cydrollinger/USB_FPGA/Docs/USB_FPGA/Readme.txt

********************************************************************************************
* Electronic Realization L.L.C.								   *
* Design: Open Hardware Source   USB Configurable Field Programmable Gate Array  	   *
*						USB_FPGA board				   *
* License: TAPR - http://www.tapr.org/OHL						   *
* Engineer: Cy Drollinger								   *
* Date: June 26th, 2012								           *
* Email: cy@elec-real.com								   *
* Address: 313 W. mendenhall #5 Bozeman, MT 59715					   *
* Phone: 406-586-5502									   *
********************************************************************************************

*******************************************
*File Arcitecture with a small description*
*******************************************

files:
		may 27 - The goals at the start of the design and the resources utilized 
		pcb_prob_soulutions - keeping track of flaws and there solutions
		pds_3an - documentation of the power distribution system designed for the FPGA
		usb power design - caluculations utilized for the resistor dividers for the LTC3544

		These files were utilized in the design process here at Electronic Realization to
		facilitate a successful outcome of the open source hardware design of the USB_FPGA.
