cydrollinger/USB_FPGA/FirstVersion/usb_fpga/order/pcb_specs.rtf

USB_FPGA

PCB specifications:

four layer board

standard substrate: fr4
thickness: .062"
dimensions: 3.2" x 2"
copper thickness: 1 oz. all layers
colors: no preference standard
all units: inches
