cydrollinger/USB_FPGA/Docs/USB_FPGA/usb power design.xls

Switching Regulator
LTC3544
projects\usb_fpga\docs\pdf\3544bfa pg.10
Vout = .8V(1 + R2/R1)
 |  | Vout | R1 | R2
 | V100 | 1.2 | 1000 | 500.00
 | V200A | 1.8 | 1000 | 1250.00
 | V200B | 2.5 | 1000 | 2125.00
 | V300 | 3.3 | 1000 | 3125.00
