cydrollinger/USB_FPGA/FirstVersion/usb_fpga/brd/board.png

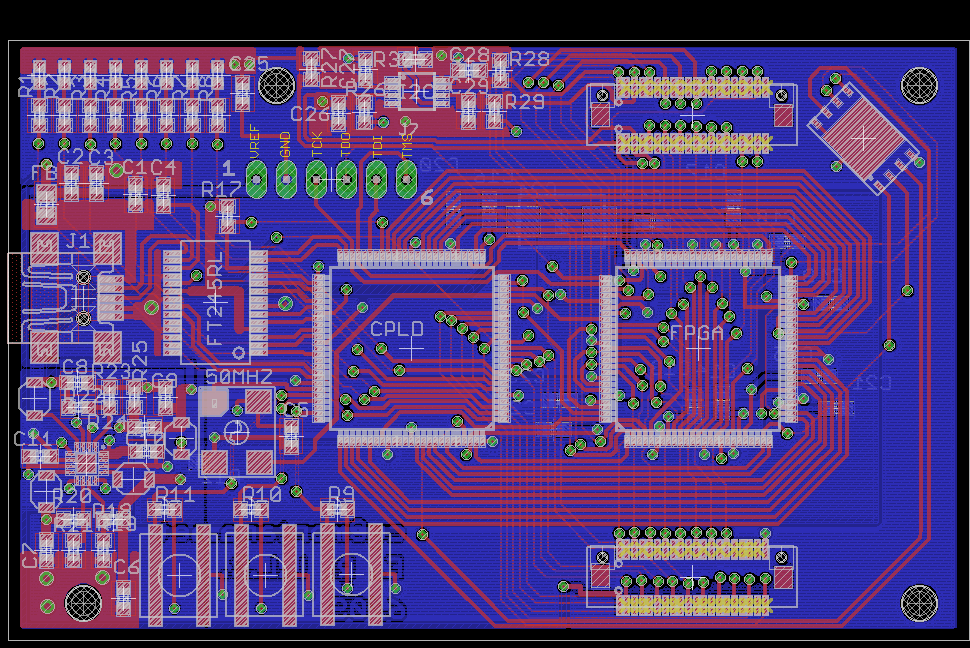
FirstVersion/usb_fpga/brd/board.png
