cydrollinger/USB_FPGA/FirstVersion/usb_fpga/brd/brd.png

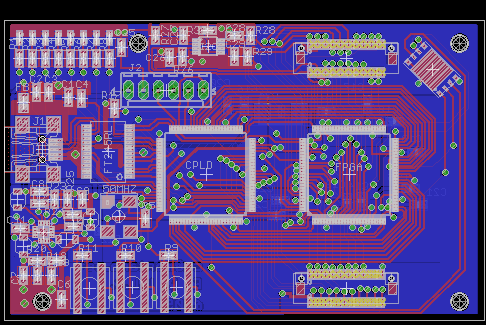
FirstVersion/usb_fpga/brd/brd.png
