cydrollinger/USB_FPGA/FirstVersion/usb_fpga/pg1.png

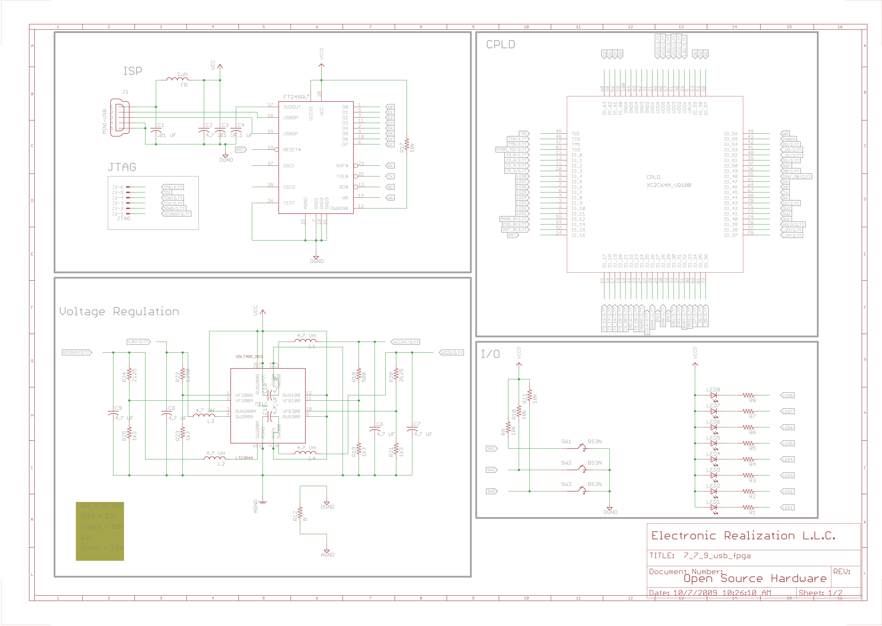
FirstVersion/usb_fpga/pg1.png
