cydrollinger/USB_FPGA/FirstVersion/usb_fpga/pg2.png

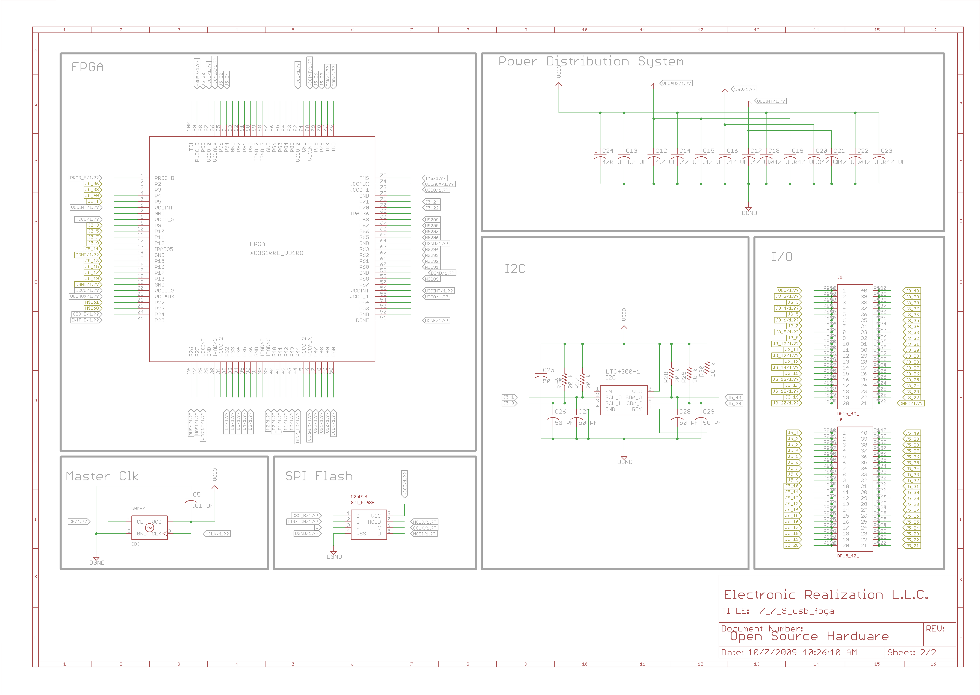
FirstVersion/usb_fpga/pg2.png
