cydrollinger/USB_FPGA/FirstVersion/usb_fpga/schematic/pg_1.png

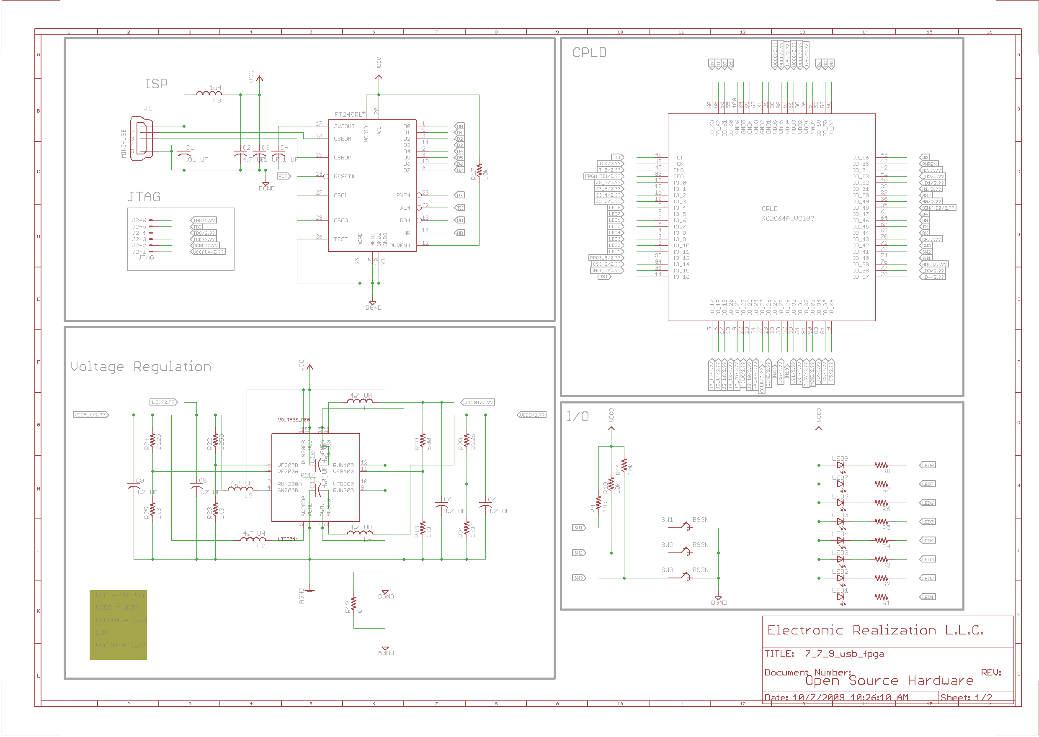
FirstVersion/usb_fpga/schematic/pg_1.png
