cydrollinger/USB_FPGA/FirstVersion/usb_fpga/usb_fpga.jpg

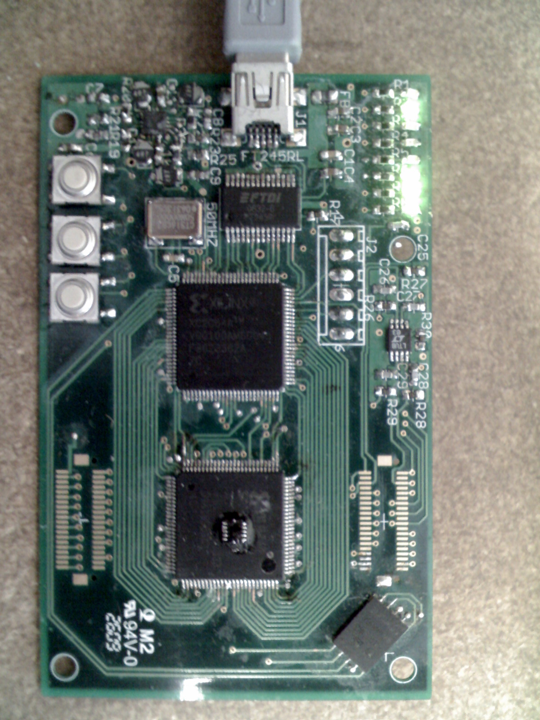
FirstVersion/usb_fpga/usb_fpga.jpg
