cydrollinger/USB_FPGA/FirstVersion/usb_fpga/web_usb_fpga-1/web_usb_fpga/content/Cartoon_brd.png

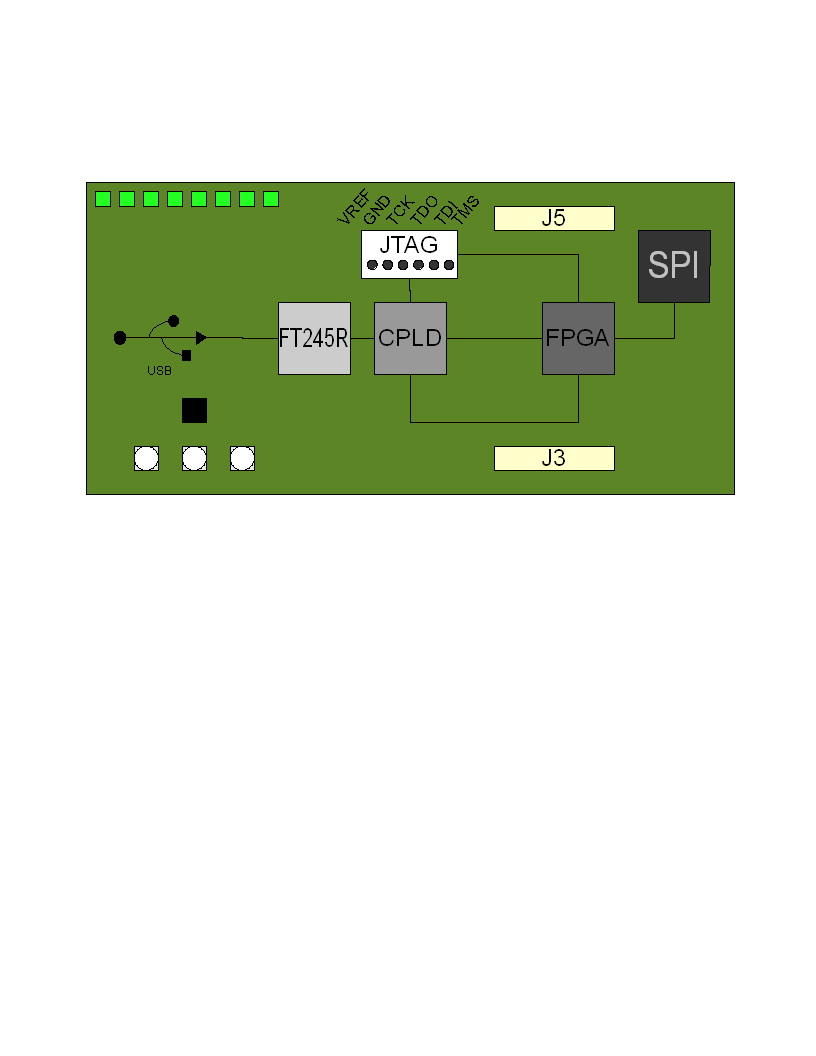
FirstVersion/usb_fpga/web_usb_fpga-1/web_usb_fpga/content/Cartoon_brd.png
