cydrollinger/USB_FPGA/IMG_0864.JPG

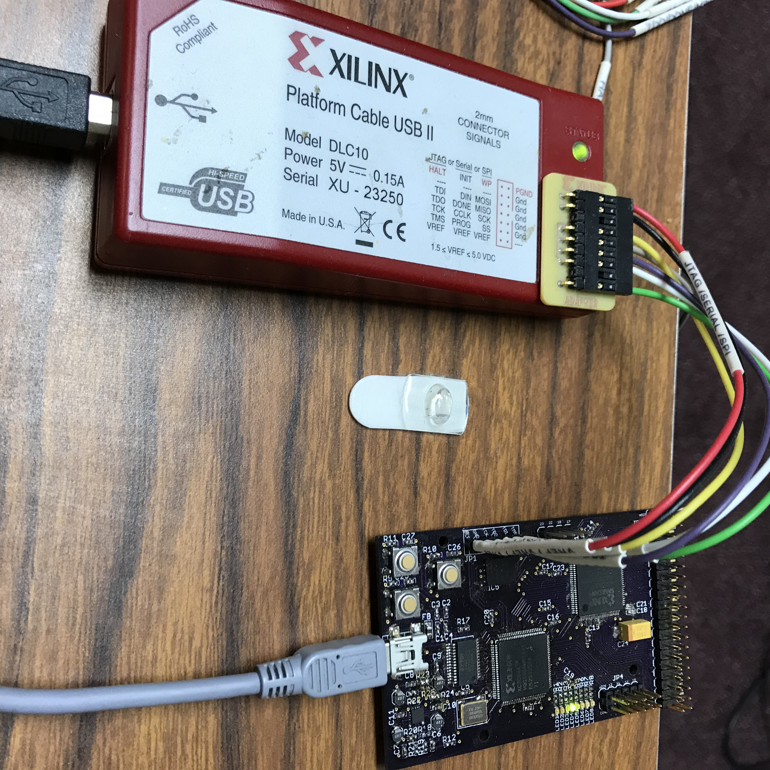
IMG_0864.JPG
