cydrollinger/USB_FPGA/FirstVersion/usb_fpga/order/usb_fpga_II.xls

Index | Quantity | Part Number | Description | Backorder Quantity | Unit Price | Extended Price | Part | parts/assy
 |  |  |  |  | USD | USD
1 (https://ordering.digikey.com/Ordering/LineItem.aspx?itemSeq=75083495) | 100 | 587-1441-1-ND | CAP CER 4.7UF 10V X5R 0603 | 0 | 0.195 | $19.50 | C2, C6, C7, C8, C9, C10, C11, C12, C13 | 9
2 (https://ordering.digikey.com/Ordering/LineItem.aspx?itemSeq=75083820) | 100 | 587-1250-1-ND | CAP CER .47UF 16V X7R 0603 | 0 | 0.0455 | $4.55 | C14, C15, C16, C17 | 4
3 (https://ordering.digikey.com/Ordering/LineItem.aspx?itemSeq=75083886) | 100 | 587-1240-1-ND | CAP CER .10UF 16V X7R 0603 | 0 | 0.0163 | $1.63 | C3, C4 | 2
4 (https://ordering.digikey.com/Ordering/LineItem.aspx?itemSeq=75083930) | 100 | 587-1239-1-ND | CAP CER 47000PF 16V X7R 0603 | 0 | 0.0325 | $3.25 | C18, C19, C20, C21, C22, C23, C30 | 7
5 (https://ordering.digikey.com/Ordering/LineItem.aspx?itemSeq=75084377) | 100 | 490-1420-1-ND | CAP CER 51PF 50V 5% C0G 0603 | 0 | 0.0423 | $4.23 | C25, C26, C27, C28, C29 | 5
6 (https://ordering.digikey.com/Ordering/LineItem.aspx?itemSeq=75084468) | 100 | 490-1525-1-ND | CAP CER 10000PF 16V 10% X7R 0603 | 0 | 0.0319 | $3.19 | C1, C5 | 2
7 (https://ordering.digikey.com/Ordering/LineItem.aspx?itemSeq=75094234) | 25 | SW261CT-ND | SWITCH TACT SMD W/O GND 160GF | 0 | 0.6772 | $16.93 | SW1, SW2, SW3 | 3
8 (https://ordering.digikey.com/Ordering/LineItem.aspx?itemSeq=75094256) | 3 | 122-1479-ND | IC SPARTAN-3E FPGA 100K 100VTQFP | 0 | 9.48 | $28.44 | fpga | 1
9 (https://ordering.digikey.com/Ordering/LineItem.aspx?itemSeq=75094321) | 3 | CTX283CT-ND | OSC 50.000 MHZ 5.0V SMD | 0 | 3.73 | $11.19 | 50MHZ | 1
10 (https://ordering.digikey.com/Ordering/LineItem.aspx?itemSeq=75094667) | 100 | 160-1183-1-ND | LED GREEN CLEAR 0603 SMD | 0 | 0.06 | $6.00 | LED1, LED2, LED3, LED4, LED5, LED6, LED7, LED8 | 8
11 (https://ordering.digikey.com/Ordering/LineItem.aspx?itemSeq=75094806) | 3 | 495-1517-1-ND | CAP TANT 470UF 6.3V 10%LOESR SMD | 0 | 1.44 | $4.32 | C24 | 1
12 (https://ordering.digikey.com/Ordering/LineItem.aspx?itemSeq=75094931) | 5 | 768-1011-1-ND | IC USB TO PARALLEL FIFO 28-SSOP | 0 | 4.5 | $22.50 | FT245RL | 1
13 (https://ordering.digikey.com/Ordering/LineItem.aspx?itemSeq=75095521) | 5 | LTC4300-1CMS8#PBF-ND | IC HOTSWAP 2WIRE BUS BUFFR 8MSOP | 0 | 3.5 | $17.50 | I2C | 1
14 (https://ordering.digikey.com/Ordering/LineItem.aspx?itemSeq=75095574) | 20 | 445-3217-1-ND | INDUCTOR POWER 4.7UH .70A SMD | 0 | 0.8 | $16.00 | L1, L2, L3, L4 | 4
15 (https://ordering.digikey.com/Ordering/LineItem.aspx?itemSeq=75095642) | 5 | H2959CT-ND | CONN RECEPT MINI USB2.0 5POS | 0 | 1.18 | $5.90 | J1 | 1
16 (https://ordering.digikey.com/Ordering/LineItem.aspx?itemSeq=75095796) | 5 | M25P16-VME6G-ND | IC SRL FLASH 16MBIT LV 8-VDFPN | 0 | 3.95 | $19.75 | SPI_FLASH | 1
17 (https://ordering.digikey.com/Ordering/LineItem.aspx?itemSeq=75096237) | 4 | H10427CT-ND | CONN RECEPT 40POS .8MM DUAL SMD | 0 | 2.47 | $9.88 | J3, J5 | 2
18 (https://ordering.digikey.com/Ordering/LineItem.aspx?itemSeq=75096346) | 4 | H10447CT-ND | CONN HEADER 40POS 3.2MM DUAL SMD | 0 | 1.95 | $7.80 | J4, J6 | 2
19 (https://ordering.digikey.com/Ordering/LineItem.aspx?itemSeq=75096442) | 5 | LTC3544BEUD#PBF-ND | IC REG SYNC QUAD 16-QFN | 0 | 5.9 | $29.50 | VOLTAGE_REG | 1
20 (https://ordering.digikey.com/Ordering/LineItem.aspx?itemSeq=75096610) | 50 | RHM165HCT-ND | RES 165 OHM 1/10W 1% 0603 SMD | 0 | 0.0408 | $2.04 | R1, R2, R3, R4, R5, R6, R7, R8 | 8
21 (https://ordering.digikey.com/Ordering/LineItem.aspx?itemSeq=75096701) | 50 | RHM1.00KHCT-ND | RES 1.00K OHM 1/10W 1% 0603 SMD | 0 | 0.0408 | $2.04 | R19, R21, R23, R25 | 4
22 (https://ordering.digikey.com/Ordering/LineItem.aspx?itemSeq=75096726) | 50 | RHM10.0KHCT-ND | RES 10.0K OHM 1/10W 1% 0603 SMD | 0 | 0.0408 | $2.04 | R17, R30 | 2
23 (https://ordering.digikey.com/Ordering/LineItem.aspx?itemSeq=75096828) | 50 | RHM20.0KHCT-ND | RES 20.0K OHM 1/10W 1% 0603 SMD | 0 | 0.0408 | $2.04 | R26, R27, R28, R29 | 4
24 (https://ordering.digikey.com/Ordering/LineItem.aspx?itemSeq=75096941) | 50 | RHM499HCT-ND | RES 499 OHM 1/10W 1% 0603 SMD | 0 | 0.0408 | $2.04 | R18 | 1
25 (https://ordering.digikey.com/Ordering/LineItem.aspx?itemSeq=75097201) | 50 | RHM3.16KHCT-ND | RES 3.16K OHM 1/10W 1% 0603 SMD | 0 | 0.0408 | $2.04 | R20 | 1
26 (https://ordering.digikey.com/Ordering/LineItem.aspx?itemSeq=75097247) | 50 | RHM1.24KHCT-ND | RES 1.24K OHM 1/10W 1% 0603 SMD | 0 | 0.0408 | $2.04 | R22 | 1
27 (https://ordering.digikey.com/Ordering/LineItem.aspx?itemSeq=75097331) | 50 | RHM2.15KHCT-ND | RES 2.15K OHM 1/10W 1% 0603 SMD | 0 | 0.0408 | $2.04 | R24 | 1
 |  | 122-1409-ND | cpld |  |  |  | cpld | 1
 |  | 240-2387-1-ND | FB |  |  |  | FB | 1
 |  | WM4104-ND |  |  |  |  | J2 | 1
 |  |  |  |  |  |  |  | 81
