cydrollinger/USB_FPGA/manufacturing/USB_FPGA/parts/digikey.xlsx

Digi-Key Part Number | Manufacturer | Manufacturer Part Number | Customer Reference | Quantity 1 | Quantity 2 | Quantity 3 | Description | Comments | RoHS Status | Lead Free Status | REACH Status
587-1223-1-ND | TAIYO YUDEN (VA) | TMK105B7103KV-F | C1,C5 | 2 | 0 | 0 | CAP CER 10000PF 25V 10% X7R 0402 | Alternate Packaging Exists | RoHS Compliant | Lead free | Unaffected Nov-2009
587-2787-1-ND | TAIYO YUDEN (VA) | JMK105BBJ475MV-F | C2,C6-13 | 9 | 0 | 0 | CAP CER 4.7UF 6.3V 20% X5R 0402 | Alternate Packaging Exists | RoHS Compliant | Lead free | Unaffected Nov-2009
587-1456-1-ND | TAIYO YUDEN (VA) | TMK105BJ104KV-F | C3,C4 | 2 | 0 | 0 | CAP CER 0.1UF 25V 10% X5R 0402 | Alternate Packaging Exists | RoHS Compliant | Lead free | Unaffected Nov-2009
587-1230-1-ND | TAIYO YUDEN (VA) | JMK105BJ474KV-F | C14,C15,C16,C17 | 4 | 0 | 0 | CAP CER 0.47UF 6.3V 10% X5R 0402 | Alternate Packaging Exists | RoHS Compliant | Lead free | Unaffected Nov-2009
587-2240-1-ND | TAIYO YUDEN (VA) | TMK105B7473KV-F | C18,C19,C20,C21,C22,C23 | 6 | 0 | 0 | CAP CER 0.047UF 25V 10% X7R 0402 | Alternate Packaging Exists | RoHS Compliant | Lead free | Unaffected Nov-2009
495-1517-1-ND | KEMET (VA) | B45197A1477K409 | C24 | 1 | 0 | 0 | CAP TANT 470UF 6.3V 10% 2917 | Alternate Packaging Exists | RoHS Compliant | Lead free | Unaffected Jan-2011
587-1231-1-ND | TAIYO YUDEN (VA) | JMK105BJ105KV-F | C25,C26,C27 | 3 | 0 | 0 | CAP CER 1UF 6.3V 10% X5R 0402 | Alternate Packaging Exists | RoHS Compliant | Lead free | Unaffected Nov-2009
CTX283CT-ND | CTS-FREQUENCY CONTROLS (VA) | CB3-3C-50M0000 | CLK | 1 | 0 | 0 | OSC 50.000 MHZ 5.0V SMD | Alternate Packaging Exists | RoHS Compliant | Lead free | Unaffected Jul-2011
490-1054-1-ND | MURATA ELECTRONICS (VA) | BLM21PG221SN1D | FB | 1 | 0 | 0 | FERRITE CHIP 220 OHM 2000MA 0805 | Alternate Packaging Exists | RoHS Compliant | Lead free | Unaffected Jul-2011
122-1409-ND | XILINX INC | XC2C64A-7VQG100C | IC1 | 1 | 0 | 0 | IC CR-II CPLD 64MCELL 100-VQFP |  | RoHS Compliant | Lead free | Unaffected Aug-2011
LTC3544BEUD#PBF-ND | LINEAR TECHNOLOGY | LTC3544BEUD#PBF | IC2 | 1 | 0 | 0 | IC BUCK SYNC QUAD ADJ 16QFN | Alternate Packaging Exists | RoHS Compliant | Lead free | Unaffected Jul-2011
768-1011-1-ND | FTDI (VA) | FT245RL-REEL | IC3 | 1 | 0 | 0 | IC USB TO PARALLEL FIFO 28-SSOP | Alternate Packaging Exists | RoHS Compliant | Lead free | Unaffected Jun-2011
122-1525-ND | XILINX INC | XC3S250E-4VQG100C | IC4 | 1 | 0 | 0 | IC SPARTAN-3E FPGA 250K 100VQFP |  | RoHS Compliant | Lead free | Unaffected Aug-2011
M25P16-VME6G-ND | MICRON TECHNOLOGY INC | M25P16-VME6G | IC5 | 1 | 0 | 0 | IC FLASH 16MBIT 75MHZ 8VDFPN | Alternate Packaging Exists | RoHS Compliant | Lead free | Unaffected Aug-2011
H2959CT-ND | HIROSE ELECTRIC CO LTD (VA) | UX60-MB-5ST | MINI_B | 1 | 0 | 0 | CONN RECEPT MINI USB2.0 5POS | Alternate Packaging Exists | RoHS Compliant | Lead free | Unaffected Sep-2011
WM8076-ND | MOLEX CONNECTOR CORPORATION | 90120-0126 | JP1 | 1 | 0 | 0 | CONN HEADER 6POS .100" STR TIN |  | RoHS Compliant | Lead free | Unaffected Dec-2009
WM8074-ND | MOLEX CONNECTOR CORPORATION | 90120-0124 | JP2 | 1 | 0 | 0 | CONN HEADER 4POS .100" STR TIN |  | RoHS Compliant | Lead free | Unaffected Dec-2009
WM8128-ND | MOLEX CONNECTOR CORPORATION | 90131-0130 | JP3 | 1 | 0 | 0 | CONN HEADER 20POS .100" STR TIN |  | RoHS Compliant | Lead free | Unaffected Dec-2009
WM8141-ND | MOLEX CONNECTOR CORPORATION | 90131-0765 | JP4,JP4_1 | 1 | 0 | 0 | CONN HEADER 10POS .100" STR GOLD |  | RoHS Compliant | Lead free | Unaffected Dec-2009
445-3217-1-ND | TDK CORPORATION (VA) | VLF3010AT-4R7MR70 | L1-4 | 4 | 0 | 0 | INDUCTOR POWER 4.7UH .70A SMD | Alternate Packaging Exists | RoHS Compliant | Lead free | Unaffected Apr-2011
160-1183-1-ND | LITE-ON INC (VA) | LTST-C190GKT | LED1-8 | 8 | 0 | 0 | LED GREEN CLEAR 0603 SMD | Alternate Packaging Exists | RoHS Compliant | Lead free | Not Available
311-120LRCT-ND | YAGEO (VA) | RC0402FR-07120RL | R1-8 | 8 | 0 | 0 | RES 120 OHM 1/16W 1% 0402 SMD | Alternate Packaging Exists | RoHS Compliant | Lead free | Unaffected Sep-2011
311-10KJRCT-ND | YAGEO (VA) | RC0402JR-0710KL | R9,R10,R11,R17 | 4 | 0 | 0 | RES 10K OHM 1/16W 5% 0402 SMD | Alternate Packaging Exists | RoHS Compliant | Lead free | Unaffected Sep-2011
311-0.0JRCT-ND | YAGEO (VA) | RC0402JR-070RL | R12 | 1 | 0 | 0 | RES 0.0 OHM 1/16W 0402 SMD | Alternate Packaging Exists | RoHS Compliant | Lead free | Unaffected Sep-2011
311-1.0KJRCT-ND | YAGEO (VA) | RC0402JR-071KL | R19,R21,R23,R25 | 4 | 0 | 0 | RES 1.0K OHM 1/16W 5% 0402 SMD | Alternate Packaging Exists | RoHS Compliant | Lead free | Unaffected Sep-2011
311-499LRCT-ND | YAGEO (VA) | RC0402FR-07499RL | R18 | 1 | 0 | 0 | RES 499 OHM 1/16W 1% 0402 SMD | Alternate Packaging Exists | RoHS Compliant | Lead free | Unaffected Sep-2011
311-3.3KJRCT-ND | YAGEO (VA) | RC0402JR-073K3L | R20 | 1 | 0 | 0 | RES 3.3K OHM 1/16W 5% 0402 SMD | Alternate Packaging Exists | RoHS Compliant | Lead free | Unaffected Sep-2011
311-1.21KLRCT-ND | YAGEO (VA) | RC0402FR-071K21L | R22 | 1 | 0 | 0 | RES 1.21K OHM 1/16W 1% 0402 SMD | Alternate Packaging Exists | RoHS Compliant | Lead free | Unaffected Sep-2011
311-2.2KJRCT-ND | YAGEO (VA) | RC0402JR-072K2L | R24 | 1 | 0 | 0 | RES 2.2K OHM 1/16W 5% 0402 SMD | Alternate Packaging Exists | RoHS Compliant | Lead free | Unaffected Sep-2011
SW261CT-ND | OMRON ELECTRONICS INC-EMC DIV (VA) | B3SN-3012P | SW1-3 | 3 | 0 | 0 | SWITCH TACTILE SPST-NO 0.05A 24V | Alternate Packaging Exists | RoHS Compliant | Lead free | Unaffected Oct-2008
