cydrollinger/USB_FPGA/manufacturing/USB_FPGA/board assembly/usb_fpga.xlsx

Open Source Hardware USB_FPGA
Measurements in Inches
License: TAPR
Part Reference | X Location | Y Location | Rotation
C1 | 0.542125984 | 1.14015748 | 90
C2 | 0.634645669 | 1.280314961 | 270
C3 | 0.542125984 | 1.280314961 | 270
C4 | 0.626377953 | 1.140551181 | 90
C5 | 0.783070866 | 0.542913386 | 0
C6 | 0.433858268 | 0.146062992 | 270
C7 | 0.161023622 | 0.146062992 | 270
C8 | 0.26496063 | 0.705905512 | 0
C9 | 0.514173228 | 0.812992126 | 90
C10 | 0.492913386 | 0.46496063 | 0
C11 | 0.138976378 | 0.461023622 | 180
C12 | 2.184645669 | 1.783464567 | 90
C13 | 2.18503937 | 0.82519685 | 270
C14 | 2.306299213 | 1.851181102 | 45
C15 | 1.714173228 | 1.166929134 | 180
C16 | 1.790944882 | 1.02519685 | 0
C17 | 1.694094488 | 1.507874016 | 180
C18 | 2.738582677 | 0.999212598 | 0
C19 | 1.936220472 | 0.461023622 | 315
C20 | 1.111023622 | 1.168897638 | 270
C21 | 2.737007874 | 1.056299213 | 0
C22 | 1.464173228 | 0.27992126 | 0
C23 | 1.857874016 | 1.477952756 | 180
C24 | 2.696062992 | 0.82992126 | 180
C25 | 0.288976378 | 1.583070866 | 0
C26 | 0.72992126 | 1.777952756 | 0
C27 | 0.296850394 | 1.922834646 | 0
CLK | 0.850393701 | 0.360629921 | 180
FB | 0.451968504 | 1.144094488 | 90
IC1 | 1.412598425 | 0.67480315 | 180
IC2 | 0.29488189 | 0.435826772 | 270
IC3 | 0.790944882 | 0.820866142 | 90
IC4 | 2.342519685 | 1.322440945 | 270
IC5 | 1.216141732 | 1.568897638 | 180
JP36 | 3.3 | 1 | 270
L1 | 0.485826772 | 0.340944882 | 270
L2 | 0.514173228 | 0.67480315 | 90
L3 | 0.118897638 | 0.611811024 | 270
L4 | 0.101968504 | 0.303937008 | 270
LED1 | 1.775984252 | 0.19488189 | 0
LED2 | 1.835826772 | 0.19488189 | 0
LED3 | 1.896062992 | 0.19488189 | 0
LED4 | 1.955905512 | 0.19488189 | 0
LED5 | 2.016141732 | 0.19488189 | 0
LED6 | 2.075984252 | 0.19488189 | 0
LED7 | 2.135826772 | 0.194094488 | 0
LED8 | 2.196062992 | 0.194094488 | 0
MINI_B | 0.232283465 | 1 | 0
R1 | 1.775984252 | 0.311023622 | 270
R2 | 1.835826772 | 0.311023622 | 270
R3 | 1.896062992 | 0.311023622 | 270
R4 | 1.955905512 | 0.311023622 | 270
R5 | 2.016141732 | 0.309055118 | 270
R6 | 2.075984252 | 0.311023622 | 270
R7 | 2.135826772 | 0.30984252 | 270
R8 | 2.196062992 | 0.307874016 | 270
R9 | 0.125984252 | 1.581102362 | 180
R10 | 0.566141732 | 1.777952756 | 180
R11 | 0.12992126 | 1.922047244 | 180
R12 | 0.609055118 | 0.120866142 | 0
R17 | 0.80984252 | 1.1 | 180
R18 | 0.383070866 | 0.248031496 | 0
R19 | 0.368897638 | 0.146062992 | 90
R20 | 0.251181102 | 0.248818898 | 180
R21 | 0.277952756 | 0.146062992 | 90
R22 | 0.26496063 | 0.624015748 | 180
R23 | 0.368897638 | 0.67992126 | 270
R24 | 0.488188976 | 0.555905512 | 0
R25 | 0.42007874 | 0.67992126 | 270
SW1 | 0.208267717 | 1.416141732 | 180
SW2 | 0.648818898 | 1.614566929 | 180
SW3 | 0.213779528 | 1.768897638 | 180
