cydrollinger/USB_FPGA/(list of files, cad)

Other CAD files:
FirstVersion/usb_fpga/VHDL/FPGA/work/fpga/behavioral.psm
PicoBlaze/PicoBlazeCPLD/picoblaze/demo_test/work/addsub8/low_level_definition.psm
PicoBlaze/PicoBlazeCPLD/picoblaze/demo_test/work/arithmetic_process/low_level_definition.psm
PicoBlaze/PicoBlazeCPLD/picoblaze/demo_test/work/carry_flag_logic/low_level_definition.psm
PicoBlaze/PicoBlazeCPLD/picoblaze/demo_test/work/demo/behavioral.psm
PicoBlaze/PicoBlazeCPLD/picoblaze/demo_test/work/demo/structure.psm
PicoBlaze/PicoBlazeCPLD/picoblaze/demo_test/work/demo_cfg/_vhdl.psm
PicoBlaze/PicoBlazeCPLD/picoblaze/demo_test/work/demo_test/v1.psm
PicoBlaze/PicoBlazeCPLD/picoblaze/demo_test/work/interrupt_capture/low_level_definition.psm
PicoBlaze/PicoBlazeCPLD/picoblaze/demo_test/work/interrupt_logic/low_level_definition.psm
PicoBlaze/PicoBlazeCPLD/picoblaze/demo_test/work/io_strobe_logic/low_level_definition.psm
PicoBlaze/PicoBlazeCPLD/picoblaze/demo_test/work/logical_bus_processing/low_level_definition.psm
PicoBlaze/PicoBlazeCPLD/picoblaze/demo_test/work/picoblaze/behavioral.psm
PicoBlaze/PicoBlazeCPLD/picoblaze/demo_test/work/program_counter/low_level_definition.psm
PicoBlaze/PicoBlazeCPLD/picoblaze/demo_test/work/ram_nx1/behavioral.psm
PicoBlaze/PicoBlazeCPLD/picoblaze/demo_test/work/ram_x1s/behavioral.psm
PicoBlaze/PicoBlazeCPLD/picoblaze/demo_test/work/register_and_flag_enable/low_level_definition.psm
PicoBlaze/PicoBlazeCPLD/picoblaze/demo_test/work/register_bank/behavioral.psm
PicoBlaze/PicoBlazeCPLD/picoblaze/demo_test/work/roc/roc_v.psm
PicoBlaze/PicoBlazeCPLD/picoblaze/demo_test/work/shift_rotate/low_level_definition.psm
PicoBlaze/PicoBlazeCPLD/picoblaze/demo_test/work/stack_counter/low_level_definition.psm
PicoBlaze/PicoBlazeCPLD/picoblaze/demo_test/work/stack_ram/low_level_definition.psm
PicoBlaze/PicoBlazeCPLD/picoblaze/demo_test/work/t_state_and_reset/low_level_definition.psm
PicoBlaze/PicoBlazeCPLD/picoblaze/demo_test/work/testbench/testbench_arch.psm
PicoBlaze/PicoBlazeCPLD/picoblaze/demo_test/work/zero_flag_logic/low_level_definition.psm
PicoBlaze/kcpsm3/Assembler/int_test.psm
PicoBlaze/kcpsm3/Assembler/uclock.psm
VHDL/USB_FPGA/FPGA/work/fpga/behavioral.psm
