cydrollinger/USB_FPGA/VHDL/USB_FPGA/FPGA/device_usage_statistics.html

### Device Usage Page (device_usage_statistics.html)

This HTML page displays the device usage statistics that will be sent to Xilinx. The file also contains predefined XML tags used to simplify processing.

Please verify the contents are okay to send to Xilinx!

Software Version and Target Device
Product Version: | ISE:11.1 (WebPack) | Target Family: | spartan3e
OS Platform: | NT | Target Device: | xc3s250e
Project ID (random number) | 10945.e1f2a1c9b99c4b55ad405598c627e341.7 | Target Package: | vq100
Registration ID | e | Target Speed: | -4
Date Generated | Tue Sep 22 10:52:56 2009

Device Usage Statistics
Macro Statistics | Miscellaneous Statistics | Net Statistics | Site Usage

Counters=1

30-bit up counter=1

MiscellaneousStatistics

AGG_BONDED_IO=9

AGG_IO=9

AGG_SLICE=15

NUM_4_INPUT_LUT=30

NUM_BONDED_IBUF=1

NUM_BONDED_IOB=8

NUM_BUFGMUX=1

NUM_CYMUX=29

NUM_LUT_RT=29

NUM_SLICEL=15

NUM_SLICE_FF=30

NUM_XOR=30

NetStatistics

NumNets_Active=55

NumNets_Gnd=1

NumNets_Vcc=1

NumNodesOfType_Active_CLKPIN=15

NumNodesOfType_Active_DOUBLE=13

NumNodesOfType_Active_DUMMY=31

NumNodesOfType_Active_DUMMYESC=1

NumNodesOfType_Active_GLOBAL=8

NumNodesOfType_Active_HUNIHEX=1

NumNodesOfType_Active_INPUT=53

NumNodesOfType_Active_IOBOUTPUT=1

NumNodesOfType_Active_OMUX=35

NumNodesOfType_Active_OUTPUT=45

NumNodesOfType_Active_VFULLHEX=2

NumNodesOfType_Active_VLONG=2

NumNodesOfType_Active_VUNIHEX=6

NumNodesOfType_Gnd_DOUBLE=1

NumNodesOfType_Gnd_INPUT=1

NumNodesOfType_Gnd_OUTPUT=1

NumNodesOfType_Gnd_PREBXBY=1

SiteStatistics

IBUF-DIFFM=1

IOB-DIFFM=3

IOB-DIFFS=4

SiteSummary

BUFGMUX=1

BUFGMUX_GCLKMUX=1

BUFGMUX_GCLK_BUFFER=1

IBUF=1

IBUF_INBUF=1

IBUF_PAD=1

IOB=8

IOB_OUTBUF=8

IOB_PAD=8

SLICEL=15

SLICEL_C1VDD=1

SLICEL_CYMUXF=15

SLICEL_CYMUXG=14

SLICEL_F=15

SLICEL_FFX=15

SLICEL_FFY=15

SLICEL_G=15

SLICEL_GNDF=14

SLICEL_GNDG=14

SLICEL_XORF=15

SLICEL_XORG=15

Configuration Data
BUFGMUX S=[S_INV:1] [S:0] BUFGMUX_GCLKMUX DISABLE_ATTR=[LOW:1] S=[S_INV:1] [S:0] IBUF_PAD IOATTRBOX=[LVCMOS25:1] IOB O1=[O1_INV:0] [O1:8] IOB_OUTBUF IN=[IN_INV:0] [IN:8] IOB_PAD DRIVEATTRBOX=[12:8] IOATTRBOX=[LVCMOS25:8] SLEW=[SLOW:8] | SLICEL BX=[BX_INV:0] [BX:1] CIN=[CIN_INV:0] [CIN:14] CLK=[CLK:15] [CLK_INV:0] SLICEL_CYMUXF 0=[0:15] [0_INV:0] 1=[1_INV:0] [1:15] SLICEL_CYMUXG 0=[0:14] [0_INV:0] SLICEL_FFX CK=[CK:15] [CK_INV:0] D=[D:15] [D_INV:0] FFX_INIT_ATTR=[INIT0:15] FFX_SR_ATTR=[SRLOW:15] LATCH_OR_FF=[FF:15] SYNC_ATTR=[ASYNC:15] | SLICEL_FFY CK=[CK:15] [CK_INV:0] D=[D:15] [D_INV:0] FFY_INIT_ATTR=[INIT0:15] FFY_SR_ATTR=[SRLOW:15] LATCH_OR_FF=[FF:15] SYNC_ATTR=[ASYNC:15] SLICEL_XORF 1=[1_INV:0] [1:15]

Pin Data
BUFGMUX I0=1 O=1 S=1 BUFGMUX_GCLKMUX I0=1 OUT=1 S=1 BUFGMUX_GCLK_BUFFER IN=1 OUT=1 IBUF I=1 PAD=1 IBUF_INBUF IN=1 OUT=1 IBUF_PAD PAD=1 | IOB O1=8 PAD=8 IOB_OUTBUF IN=8 OUT=8 IOB_PAD PAD=8 SLICEL BX=1 CIN=14 CLK=15 COUT=14 F1=15 G1=15 XQ=15 YQ=15 | SLICEL_C1VDD 1=1 SLICEL_CYMUXF 0=15 1=15 OUT=15 S0=15 SLICEL_CYMUXG 0=14 1=14 OUT=14 S0=14 SLICEL_F A1=15 D=15 SLICEL_FFX CK=15 D=15 Q=15 | SLICEL_FFY CK=15 D=15 Q=15 SLICEL_G A1=15 D=15 SLICEL_GNDF 0=14 SLICEL_GNDG 0=14 SLICEL_XORF 0=15 1=15 O=15 SLICEL_XORG 0=15 1=15 O=15

Tool Usage

Command Line History

xst -ise <ise_file>

ngdbuild -ise <ise_file> -intstyle ise -dd _ngo -nt timestamp -i -p xc3s100e-vq100-5 <fname>.ngc <fname>.ngd

map -ise <ise_file> -intstyle ise -p xc3s100e-vq100-5 -cm area -ir off -pr off -c 100 -o <fname>.ncd <fname>.ngd <fname>.pcf

par -ise <ise_file> -w -intstyle ise -ol std -t 1 <fname>.ncd <fname>.ncd <fname>.pcf

trce -ise <ise_file> -intstyle ise -v 3 -s 5 -fastpaths -xml <fname>.twx <fname>.ncd -o <fname>.twr <fname>.pcf -ucf <fname>.ucf

bitgen -ise <ise_file> -intstyle ise -f <fname>.ut <fname>.ncd

xst -ise <ise_file>

xst -ise <ise_file>

xst -ise <ise_file>

xst -ise <ise_file>

xst -ise <ise_file>

xst -ise <ise_file>

ngdbuild -ise <ise_file> -intstyle ise -dd _ngo -nt timestamp -i -p xc3s100e-vq100-5 <fname>.ngc <fname>.ngd

map -ise <ise_file> -intstyle ise -p xc3s100e-vq100-5 -cm area -ir off -pr off -c 100 -o <fname>.ncd <fname>.ngd <fname>.pcf

ngdbuild -ise <ise_file> -intstyle ise -dd _ngo -nt timestamp -i -p xc3s100e-vq100-5 <fname>.ngc <fname>.ngd

map -ise <ise_file> -intstyle ise -p xc3s100e-vq100-5 -cm area -ir off -pr off -c 100 -o <fname>.ncd <fname>.ngd <fname>.pcf

par -ise <ise_file> -w -intstyle ise -ol std -t 1 <fname>.ncd <fname>.ncd <fname>.pcf

trce -ise <ise_file> -intstyle ise -v 3 -s 5 -fastpaths -xml <fname>.twx <fname>.ncd -o <fname>.twr <fname>.pcf -ucf <fname>.ucf

bitgen -ise <ise_file> -intstyle ise -f <fname>.ut <fname>.ncd

xst -ise <ise_file>

ngdbuild -ise <ise_file> -intstyle ise -dd _ngo -nt timestamp -i -p xc3s250e-vq100-5 <fname>.ngc <fname>.ngd

map -ise <ise_file> -intstyle ise -p xc3s250e-vq100-5 -cm area -ir off -pr off -c 100 -o <fname>.ncd <fname>.ngd <fname>.pcf

par -ise <ise_file> -w -intstyle ise -ol std -t 1 <fname>.ncd <fname>.ncd <fname>.pcf

trce -ise <ise_file> -intstyle ise -v 3 -s 5 -fastpaths -xml <fname>.twx <fname>.ncd -o <fname>.twr <fname>.pcf -ucf <fname>.ucf

bitgen -ise <ise_file> -intstyle ise -f <fname>.ut <fname>.ncd

xst -ise <ise_file>

xst -ise <ise_file>

xst -ise <ise_file>

ngdbuild -ise <ise_file> -intstyle ise -dd _ngo -nt timestamp -i -p xc3s250e-vq100-5 <fname>.ngc <fname>.ngd

map -ise <ise_file> -intstyle ise -p xc3s250e-vq100-5 -cm area -ir off -pr off -c 100 -o <fname>.ncd <fname>.ngd <fname>.pcf

par -ise <ise_file> -w -intstyle ise -ol std -t 1 <fname>.ncd <fname>.ncd <fname>.pcf

trce -ise <ise_file> -intstyle ise -v 3 -s 5 -fastpaths -xml <fname>.twx <fname>.ncd -o <fname>.twr <fname>.pcf -ucf <fname>.ucf

bitgen -ise <ise_file> -intstyle ise -f <fname>.ut <fname>.ncd

xst -ise <ise_file>

ngdbuild -ise <ise_file> -intstyle ise -dd _ngo -nt timestamp -i -p xc3s100e-vq100-5 <fname>.ngc <fname>.ngd

map -ise <ise_file> -intstyle ise -p xc3s100e-vq100-5 -cm area -ir off -pr off -c 100 -o <fname>.ncd <fname>.ngd <fname>.pcf

par -ise <ise_file> -w -intstyle ise -ol std -t 1 <fname>.ncd <fname>.ncd <fname>.pcf

trce -ise <ise_file> -intstyle ise -v 3 -s 5 -fastpaths -xml <fname>.twx <fname>.ncd -o <fname>.twr <fname>.pcf -ucf <fname>.ucf

bitgen -ise <ise_file> -intstyle ise -f <fname>.ut <fname>.ncd

xst -ise <ise_file>

ngdbuild -ise <ise_file> -intstyle ise -dd _ngo -nt timestamp -i -p xc3s250e-vq100-5 <fname>.ngc <fname>.ngd

map -ise <ise_file> -intstyle ise -p xc3s250e-vq100-5 -cm area -ir off -pr off -c 100 -o <fname>.ncd <fname>.ngd <fname>.pcf

par -ise <ise_file> -w -intstyle ise -ol std -t 1 <fname>.ncd <fname>.ncd <fname>.pcf

trce -ise <ise_file> -intstyle ise -v 3 -s 5 -fastpaths -xml <fname>.twx <fname>.ncd -o <fname>.twr <fname>.pcf -ucf <fname>.ucf

bitgen -ise <ise_file> -intstyle ise -f <fname>.ut <fname>.ncd

xst -ise <ise_file>

ngdbuild -ise <ise_file> -intstyle ise -dd _ngo -nt timestamp -i -p xc3s250e-vq100-4 <fname>.ngc <fname>.ngd

map -ise <ise_file> -intstyle ise -p xc3s250e-vq100-4 -cm area -ir off -pr off -c 100 -o <fname>.ncd <fname>.ngd <fname>.pcf

par -ise <ise_file> -w -intstyle ise -ol std -t 1 <fname>.ncd <fname>.ncd <fname>.pcf

trce -ise <ise_file> -intstyle ise -v 3 -s 4 -fastpaths -xml <fname>.twx <fname>.ncd -o <fname>.twr <fname>.pcf -ucf <fname>.ucf

bitgen -ise <ise_file> -intstyle ise -f <fname>.ut <fname>.ncd

Software Quality
Run Statistics
XSLTProcess | 151 | 151 | 0 | 0 | 0 | 0 | 0
_impact | 53 | 41 | 0 | 0 | 0 | 0 | 0
bitgen | 58 | 58 | 0 | 0 | 0 | 0 | 0
cpldfit | 151 | 151 | 0 | 0 | 0 | 0 | 0
hprep6 | 146 | 146 | 0 | 0 | 0 | 0 | 0
map | 118 | 88 | 0 | 0 | 0 | 0 | 0
ngdbuild | 228 | 217 | 0 | 0 | 0 | 0 | 0
par | 53 | 25 | 28 | 0 | 0 | 0 | 0
taengine | 146 | 146 | 0 | 0 | 0 | 0 | 0
trce | 7 | 7 | 0 | 0 | 0 | 0 | 0
tsim | 146 | 146 | 0 | 0 | 0 | 0 | 0
xst | 336 | 333 | 0 | 0 | 0 | 0 | 0

Help Statistics
Search words with results
pullup resistor ( 1 ) | rising edge ( 1 )
Unsuccessful Search words
rising_edge ( 1 ) | risingedge ( 1 )
Help files
/doc/usenglish/isehelp/ ( 1 ) | /doc/usenglish/isehelp/ise_c_overview.htm ( 1 )
/doc/usenglish/isehelp/ite_c_overview.htm ( 2 ) | /doc/usenglish/isehelp/pim_db_commsetupdlg.htm ( 1 )
/doc/usenglish/isehelp/pim_p_connectingtocables.htm ( 1 ) | /doc/usenglish/isehelp/pp_db_fitting_properties_xpla3.htm ( 1 )

/doc/usenglish/isehelp/sse_c_nets.htm ( 1 )

Project Statistics
PROP_Synthesis_Tool=XST (VHDL/Verilog) | PROP_Simulator=Modelsim-XE VHDL
PROP_Top_Level_Module_Type=HDL | PROP_PreferredLanguage=VHDL
PROP_Enable_Message_Filtering=false | PROP_Enable_Incremental_Messaging=false
PROP_UseSmartGuide=false | Partitions count=1
FILE_UCF=1 | FILE_VHDL=1
PROP_DevDevice=xc3s250e | PROP_DevFamily=Spartan3E
PROP_DevSpeed=-4 | PROP_FitterReportFormat=HTML
PROP_ProjectDescription=First programming of the fpga | PROP_Simulator=Modelsim-XE VHDL
PROP_UserConstraintEditorPreference=Constraints Editor | PROP_lockPinsUcfFile=changed

Project duration(days)=76
