cydrollinger/USB_FPGA/manufacturing/USB_FPGA/gerber/image_3D.png

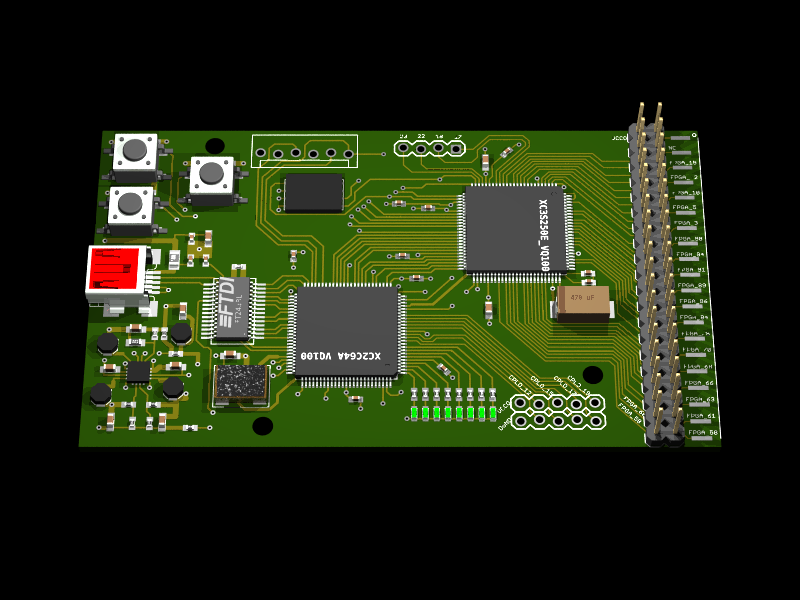
manufacturing/USB_FPGA/gerber/image_3D.png
