cydrollinger/USB_FPGA/VHDL/USB_FPGA/test_cpld/CPLD_summary.html

CPLD Project Status (04/16/2018 - 18:43:33)
Project File: | test_cpld.xise | Parser Errors: | No Errors
Module Name: | CPLD | Implementation State: | Fitted
Target Device: | xc2c256-7VQ100 | Errors: | No Errors
Product Version: | ISE 14.7 | Warnings: | No Warnings
Design Goal: | Balanced | Routing Results:
Design Strategy: | Xilinx Default (unlocked) | Timing Constraints:
Environment: | System Settings | Final Timing Score:

Detailed Reports | | | | | | [-]
Report Name | Status | Generated | Errors | Warnings | Infos
Synthesis Report | Current | Mon Apr 16 18:43:16 2018 | 0 | 0 | 0
Translation Report | Current | Mon Apr 16 18:43:19 2018 | 0 | 0 | 0
CPLD Fitter Report (Text) | Current | Mon Apr 16 18:43:26 2018 | 0 | 1 Warning (1 new) | 1 Info (1 new)
Power Report

Secondary Reports | | | [-]
Report Name | Status | Generated
Post-Fit Simulation Model Report

Date Generated: 04/16/2018 - 18:43:33
