cydrollinger/USB_FPGA/VHDL/USB_FPGA/test_cpld/FPGA_summary.html

test_cpld Project Status
Project File: | test_cpld.ise | Implementation State: | New
Module Name: | FPGA | Errors:
Target Device: | xc3s250e-5vq100 | Warnings:
Product Version: | ISE 11.1 | Routing Results:
Design Goal: | Balanced | Timing Constraints:
Design Strategy: | Xilinx Default (unlocked) | Final Timing Score:

Detailed Reports | | | | | | [-]
Report Name | Status | Generated | Errors | Warnings | Infos
Synthesis Report
Translation Report
Map Report
Place and Route Report
Power Report
Post-PAR Static Timing Report
Bitgen Report

Secondary Reports | | | [-]
Report Name | Status | Generated

Date Generated: 09/22/2009 - 10:25:35
