cydrollinger/USB_FPGA/VHDL/USB_FPGA/test_cpld_II/CPLD_summary.html

CPLD Project Status (05/07/2018 - 18:52:00)
Project File: | test_cpld.xise | Parser Errors: | No Errors
Module Name: | CPLD | Implementation State: | Translated
Target Device: | xc2c64a-7VQ100 | Errors: | No Errors
Product Version: | ISE 14.7 | Warnings: | No Warnings
Design Goal: | Balanced | Routing Results:
Design Strategy: | Xilinx Default (unlocked) | Timing Constraints:
Environment: | System Settings | Final Timing Score:

Detailed Reports | | | | | | [-]
Report Name | Status | Generated | Errors | Warnings | Infos
Synthesis Report | Current | Mon May 7 18:30:50 2018 | 0 | 0 | 1 Info (0 new)
Translation Report | Current | Mon May 7 18:51:59 2018 | 0 | 0 | 0
CPLD Fitter Report (Text) | Out of Date | Mon Apr 16 19:26:54 2018 | 0 | 1 Warning (1 new) | 1 Info (1 new)
Power Report

Secondary Reports | | | [-]
Report Name | Status | Generated
Post-Fit Simulation Model Report

Date Generated: 05/07/2018 - 18:52:00
