cydrollinger/USB_FPGA/FirstVersion/usb_fpga/VHDL/test_cpld/CPLD_summary.html

CPLD Project Status (09/10/2009 - 13:46:32)
Project File: | test_cpld.xise | Parser Errors: | No Errors
Module Name: | CPLD | Implementation State: | Fitted
Target Device: | xc2c64a-7VQ100 | Errors: | No Errors
Product Version: | ISE 14.7 | Warnings: | No Warnings
Design Goal: | Balanced | Routing Results:
Design Strategy: | Xilinx Default (unlocked) | Timing Constraints:
Environment: | System Settings | Final Timing Score:

Detailed Reports | | | | | | [-]
Report Name | Status | Generated | Errors | Warnings | Infos
Synthesis Report | Current | Sat Mar 24 12:54:03 2018 | 0 | 0 | 0
Translation Report | Current | Sat Mar 24 12:54:06 2018 | 0 | 0 | 0
CPLD Fitter Report (Text) | Current | Sat Mar 24 12:54:14 2018 | 0 | 1 Warning (1 new) | 1 Info (1 new)
Power Report

Secondary Reports | | | [-]
Report Name | Status | Generated
Post-Fit Simulation Model Report
WebTalk Report | Current | Sat Mar 24 18:55:34 2018
WebTalk Log File | Current | Sat Mar 24 18:55:37 2018

Date Generated: 03/24/2018 - 18:55:55
