cydrollinger/USB_FPGA/VHDL/USB_FPGA/test_cpld/CPLD_envsettings.html

System Settings

Environment Settings
Environment Variable | xst | ngdbuild
PATHEXT | .COM; .EXE; .BAT; .CMD; .VBS; .VBE; .JS; .JSE; .WSF; .WSH; .MSC; .PY; .PYW | .COM; .EXE; .BAT; .CMD; .VBS; .VBE; .JS; .JSE; .WSF; .WSH; .MSC; .PY; .PYW

Path

C:\Xilinx\14.7\ISE_DS\ISE\\lib\nt64;
C:\Xilinx\14.7\ISE_DS\ISE\\bin\nt64;
C:\Xilinx\14.7\ISE_DS\ISE\bin\nt64;
C:\Xilinx\14.7\ISE_DS\ISE\lib\nt64;
C:\Xilinx\14.7\ISE_DS\ISE\..\..\..\DocNav;
C:\Xilinx\14.7\ISE_DS\PlanAhead\bin;
C:\Xilinx\14.7\ISE_DS\EDK\bin\nt64;
C:\Xilinx\14.7\ISE_DS\EDK\lib\nt64;
C:\Xilinx\14.7\ISE_DS\EDK\gnu\microblaze\nt\bin;
C:\Xilinx\14.7\ISE_DS\EDK\gnu\powerpc-eabi\nt\bin;
C:\Xilinx\14.7\ISE_DS\EDK\gnuwin\bin;
C:\Xilinx\14.7\ISE_DS\EDK\gnu\arm\nt\bin;
C:\Xilinx\14.7\ISE_DS\EDK\gnu\microblaze\linux_toolchain\nt64_be\bin;
C:\Xilinx\14.7\ISE_DS\EDK\gnu\microblaze\linux_toolchain\nt64_le\bin;
C:\Xilinx\14.7\ISE_DS\common\bin\nt64;
C:\Xilinx\14.7\ISE_DS\common\lib\nt64;
C:\ProgramData\Oracle\Java\javapath;
C:\Program Files (x86)\Microchip\MPLAB C30\bin;
C:\Program Files (x86)\Intel\iCLS Client\;
C:\Program Files\Intel\iCLS Client\;
C:\WINDOWS\system32;
C:\WINDOWS;
C:\WINDOWS\System32\Wbem;
C:\WINDOWS\System32\WindowsPowerShell\v1.0\;
C:\Program Files (x86)\Intel\Intel(R) Management Engine Components\DAL;
C:\Program Files\Intel\Intel(R) Management Engine Components\DAL;
C:\Program Files (x86)\Intel\Intel(R) Management Engine Components\IPT;
C:\Program Files\Intel\Intel(R) Management Engine Components\IPT;
C:\Program Files (x86)\Microchip\xc16\v1.31\bin;
C:\Program Files (x86)\Microchip\xc32\v1.44\bin;
C:\Program Files (x86)\NVIDIA Corporation\PhysX\Common;
C:\Program Files (x86)\Common Files\Intuit\QBPOSSDKRuntime;
C:\Program Files\Git\cmd;
C:\Program Files\doxygen\bin;
C:\Program FIles (x86)\Graphviz2.38\bin;
C:\Program Files (x86)\Nordic Semiconductor\nrf5x\bin\;
C:\Program Files (x86)\GnuWin32\bin;
C:\Program Files\PuTTY\;
C:\Python\v3.6.5\Scripts\;
C:\Python\v3.6.5\;
C:\WINDOWS\System32\OpenSSH\;
C:\Program Files (x86)\GNU Tools ARM Embedded\4.9 2015q3\bin;
C:\Users\Cy\AppData\Local\Microsoft\WindowsApps;
C:\Program Files (x86)\CMake\bin;
C:\Program Files\CMake\bin;
C:\mingw\bin;
C:\Program Files(x86)\Nordic Semiconductor\nrf5x\bin;
C:\Program Files\Microsoft VS Code\bin

C:\Xilinx\14.7\ISE_DS\ISE\\lib\nt64;
C:\Xilinx\14.7\ISE_DS\ISE\\bin\nt64;
C:\Xilinx\14.7\ISE_DS\ISE\bin\nt64;
C:\Xilinx\14.7\ISE_DS\ISE\lib\nt64;
C:\Xilinx\14.7\ISE_DS\ISE\..\..\..\DocNav;
C:\Xilinx\14.7\ISE_DS\PlanAhead\bin;
C:\Xilinx\14.7\ISE_DS\EDK\bin\nt64;
C:\Xilinx\14.7\ISE_DS\EDK\lib\nt64;
C:\Xilinx\14.7\ISE_DS\EDK\gnu\microblaze\nt\bin;
C:\Xilinx\14.7\ISE_DS\EDK\gnu\powerpc-eabi\nt\bin;
C:\Xilinx\14.7\ISE_DS\EDK\gnuwin\bin;
C:\Xilinx\14.7\ISE_DS\EDK\gnu\arm\nt\bin;
C:\Xilinx\14.7\ISE_DS\EDK\gnu\microblaze\linux_toolchain\nt64_be\bin;
C:\Xilinx\14.7\ISE_DS\EDK\gnu\microblaze\linux_toolchain\nt64_le\bin;
C:\Xilinx\14.7\ISE_DS\common\bin\nt64;
C:\Xilinx\14.7\ISE_DS\common\lib\nt64;
C:\ProgramData\Oracle\Java\javapath;
C:\Program Files (x86)\Microchip\MPLAB C30\bin;
C:\Program Files (x86)\Intel\iCLS Client\;
C:\Program Files\Intel\iCLS Client\;
C:\WINDOWS\system32;
C:\WINDOWS;
C:\WINDOWS\System32\Wbem;
C:\WINDOWS\System32\WindowsPowerShell\v1.0\;
C:\Program Files (x86)\Intel\Intel(R) Management Engine Components\DAL;
C:\Program Files\Intel\Intel(R) Management Engine Components\DAL;
C:\Program Files (x86)\Intel\Intel(R) Management Engine Components\IPT;
C:\Program Files\Intel\Intel(R) Management Engine Components\IPT;
C:\Program Files (x86)\Microchip\xc16\v1.31\bin;
C:\Program Files (x86)\Microchip\xc32\v1.44\bin;
C:\Program Files (x86)\NVIDIA Corporation\PhysX\Common;
C:\Program Files (x86)\Common Files\Intuit\QBPOSSDKRuntime;
C:\Program Files\Git\cmd;
C:\Program Files\doxygen\bin;
C:\Program FIles (x86)\Graphviz2.38\bin;
C:\Program Files (x86)\Nordic Semiconductor\nrf5x\bin\;
C:\Program Files (x86)\GnuWin32\bin;
C:\Program Files\PuTTY\;
C:\Python\v3.6.5\Scripts\;
C:\Python\v3.6.5\;
C:\WINDOWS\System32\OpenSSH\;
C:\Program Files (x86)\GNU Tools ARM Embedded\4.9 2015q3\bin;
C:\Users\Cy\AppData\Local\Microsoft\WindowsApps;
C:\Program Files (x86)\CMake\bin;
C:\Program Files\CMake\bin;
C:\mingw\bin;
C:\Program Files(x86)\Nordic Semiconductor\nrf5x\bin;
C:\Program Files\Microsoft VS Code\bin
XILINX | C:\Xilinx\14.7\ISE_DS\ISE\ | C:\Xilinx\14.7\ISE_DS\ISE\
XILINX_DSP | C:\Xilinx\14.7\ISE_DS\ISE | C:\Xilinx\14.7\ISE_DS\ISE
XILINX_EDK | C:\Xilinx\14.7\ISE_DS\EDK | C:\Xilinx\14.7\ISE_DS\EDK
XILINX_PLANAHEAD | C:\Xilinx\14.7\ISE_DS\PlanAhead | C:\Xilinx\14.7\ISE_DS\PlanAhead

Synthesis Property Settings
Switch Name | Property Name | Value | Default Value
-ifn | | CPLD.prj
-ifmt | | mixed | MIXED
-ofn | | CPLD
-ofmt | | NGC | NGC
-p | | xbr
-top | | CPLD
-opt_mode | Optimization Goal | Speed | SPEED
-opt_level | Optimization Effort | 1 | 1
-iuc | Use synthesis Constraints File | NO | NO
-keep_hierarchy | Keep Hierarchy | Yes | YES
-netlist_hierarchy | Netlist Hierarchy | As_Optimized | as_optimized
-rtlview | Generate RTL Schematic | Yes | NO
-bus_delimiter | Bus Delimiter | <> | <>
-verilog2001 | Verilog 2001 | YES | YES
-fsm_extract | | YES | YES
-fsm_encoding | | Auto | AUTO
-safe_implementation | | No | NO
-resource_sharing | | YES | YES
-iobuf | | YES | YES
-equivalent_register_removal | | YES | YES

Translation Property Settings
Switch Name | Property Name | Value | Default Value
-intstyle | | ise | None
-dd | | _ngo | None
-p | | xc2c256-VQ100-7 | None
-uc | | cpld.ucf | None

Operating System Information
Operating System Information | xst | ngdbuild
CPU Architecture/Speed | Intel(R) Core(TM) i7-7740X CPU @ 4.30GHz/4296 MHz | Intel(R) Core(TM) i7-7740X CPU @ 4.30GHz/4296 MHz
Host | Taylors_Fork | Taylors_Fork
OS Name | Microsoft , 64-bit | Microsoft , 64-bit
OS Release | major release (build 9200) | major release (build 9200)
