cydrollinger/USB_FPGA/eagle/USB_FPGA/usb_fpga.brd

## EAGLE design eagle/USB_FPGA/usb_fpga.brd (2019-04-05)

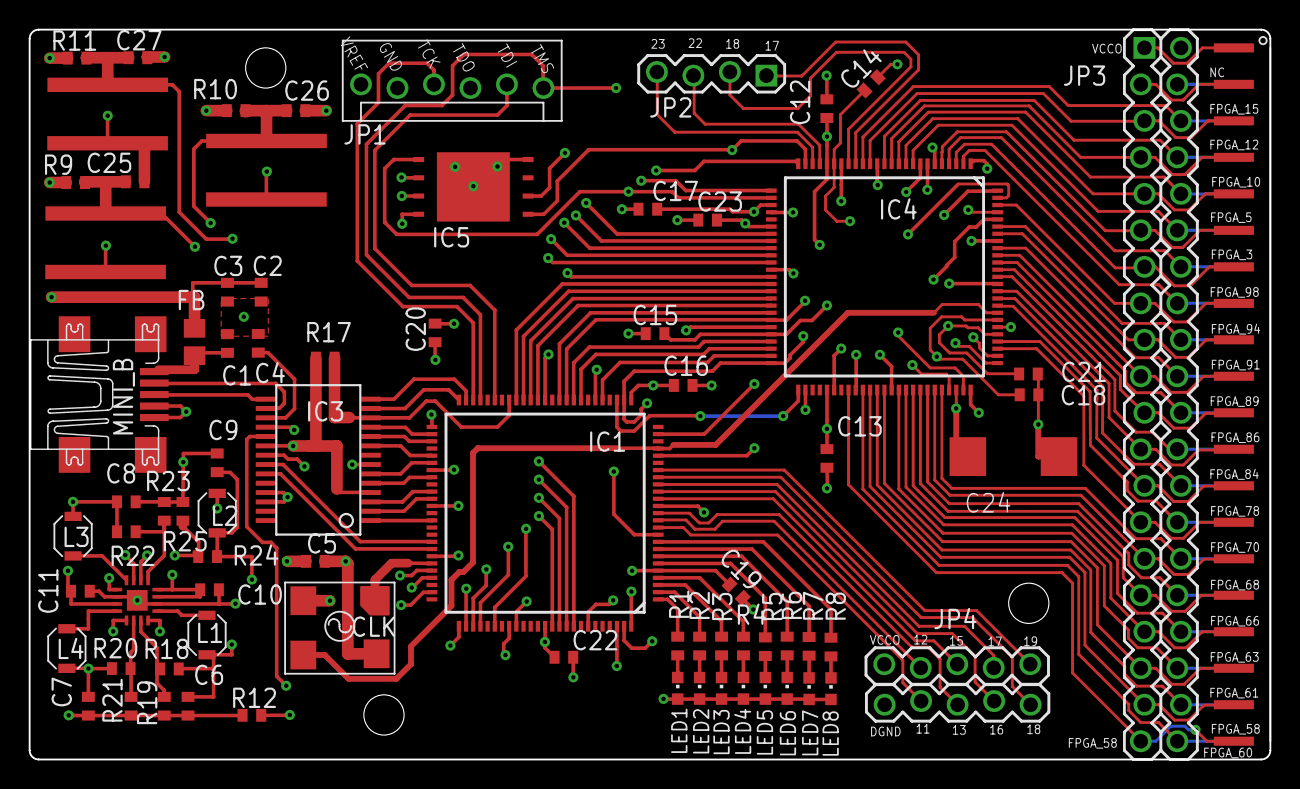
[picture p28: board usb_fpga.brd from above]

Board: 4 copper layers, 86.4 x 50.8 mm, 77 parts (0 on the bottom side), 133 nets.

Parts:
C1, C5: .01 UF; C0402
C2, C6, C7, C8, C9, C10, C11, C12, C13: 4.7 UF; C0402
C3, C4: .1 UF; C0402
C14, C15, C16, C17: .47 UF; C0402
C18, C19, C20, C21, C22, C23: .047 UF; C0402
C24: 470 uF; D/7343-31R
C25, C26, C27: C0402
CLK: 50MHz; CB3
FB: 1uH; R0805
IC1: XC2C64A_VQ100; VQ100
IC2: LTC3544; QFN16
IC3: FT245RL; SSOP28DB
IC4: XC3S250E_VQ100; VQ100
IC5: M25P16; VDFPN8
JP1: MOLEX-1X6_LOCK
JP2: 1X04_LOCK
JP3: LOCK_40
JP4, JP4_1: 1X05_LOCK
JP36: BRD_EDGE_40; STRADDLE_40
L1, L2, L3, L4: 4.7 uH; L3010
LED1, LED2, LED3, LED4, LED5, LED6, LED7, LED8: CHIPLED_0603
MINI_B: none; UX60A-MB-5ST
R1, R2, R3, R4, R5, R6, R7, R8: R0402
R9, R10, R11, R17: 10k; R0402
R12: 0; R0402
R18: 500; R0402
R19, R21, R23, R25: 1k3; R0402
R20: 3125; R0402
R22: 1250; R0402
R24: 2125; R0402
SW1, SW2, SW3: BS3N

Connections:
1.8V: C8.1, C16.1, C20.1, IC1.26, IC1.57, L3.P$1, R22.2
AGND: C6.2, C7.2, C8.2, C9.2, C10.2, C11.1, IC2.6, IC2.14, IC2.P$17, R12.1, R19.1, R21.1, R23.1, R25.1
BUSY: IC1.91, IC4.26
CCLK: IC1.27, IC4.50, IC5.6
CE: CLK.1, IC1.70
CPLD_11: IC1.11, JP4_1.4
CPLD_12: IC1.12, JP4.2
CPLD_13: IC1.13, JP4_1.3
CPLD_15: IC1.15, JP4.3
CPLD_16: IC1.16, JP4_1.2
CPLD_17: IC1.17, JP4.4
CPLD_18: IC1.18, JP4_1.1
CPLD_19: IC1.19, JP4.5
CSO_B: IC1.94, IC4.24, IC5.1
D0: IC1.64, IC3.1
D1: IC1.58, IC3.5
D2: IC1.60, IC3.3
D3: IC1.52, IC3.11
D4: IC1.61, IC3.2
D5: IC1.55, IC3.9
D6: IC1.53, IC3.10
D7: IC1.56, IC3.6
DGND: C1.2, C2.2, C3.2, C4.2, C5.1, C12.2, C13.2, C14.2, C15.2, C16.2, C17.2, C18.2, C19.2, C20.2, C21.2, C22.2, C23.2, C24.-, C25.2, C26.2, C27.2, CLK.2, IC1.21, IC1.31, IC1.62, IC1.69, IC1.84, IC1.100, IC3.7, IC3.18, IC3.21, IC3.25, IC3.26, IC4.7, IC4.14, IC4.19, IC4.29, IC4.37, IC4.52, IC4.59, IC4.64, IC4.72, IC4.81, IC4.87, IC4.93, IC5.4, JP1.2, JP3.40, JP4_1.5, JP36.P$40, MINI_B.4, MINI_B.5, R12.2, SW1.2, SW2.2, SW3.2
DIN/_D0: IC1.35, IC4.44, IC5.2
DONE: IC1.28, IC4.51
FPGA_2: IC4.2, JP3.33, JP36.P$33
FPGA_3: IC4.3, JP3.7, JP36.P$7
FPGA_4: IC4.4, JP3.34, JP36.P$34
FPGA_5: IC4.5, JP3.6, JP36.P$6
FPGA_9: IC4.9, JP3.35, JP36.P$35
FPGA_10: IC4.10, JP3.5, JP36.P$5
FPGA_11: IC4.11, JP3.36, JP36.P$36
FPGA_12: IC4.12, JP3.4, JP36.P$4
FPGA_13: IC4.13, JP3.37, JP36.P$37
FPGA_15: IC4.15, JP3.3, JP36.P$3
FPGA_16: IC4.16, JP3.38, JP36.P$38
FPGA_17: IC4.17, JP2.1
FPGA_18: IC4.18, JP2.2
FPGA_22: IC4.22, JP2.3
FPGA_23: IC4.23, JP2.4
FPGA_58: IC4.58, JP3.20, JP36.P$20
FPGA_60: IC4.60, JP3.21, JP36.P$21
FPGA_61: IC4.61, JP3.19, JP36.P$19
FPGA_62: IC4.62, JP3.22, JP36.P$22
FPGA_63: IC4.63, JP3.18, JP36.P$18
FPGA_65: IC4.65, JP3.23, JP36.P$23
FPGA_66: IC4.66, JP3.17, JP36.P$17
FPGA_67: IC4.67, JP3.24, JP36.P$24
FPGA_68: IC4.68, JP3.16, JP36.P$16
FPGA_69: IC4.69, JP3.25, JP36.P$25
FPGA_70: IC4.70, JP3.15, JP36.P$15
FPGA_71: IC4.71, JP3.26, JP36.P$26
FPGA_78: IC4.78, JP3.14, JP36.P$14
FPGA_79: IC4.79, JP3.27, JP36.P$27
FPGA_84: IC4.84, JP3.13, JP36.P$13
FPGA_85: IC4.85, JP3.28, JP36.P$28
FPGA_86: IC4.86, JP3.12, JP36.P$12
FPGA_88: IC4.88, JP3.29, JP36.P$29
FPGA_89: IC4.89, JP3.11, JP36.P$11
FPGA_90: IC4.90, JP3.30, JP36.P$30
FPGA_91: IC4.91, JP3.10, JP36.P$10
FPGA_92: IC4.92, JP3.31, JP36.P$31
FPGA_94: IC4.94, JP3.9, JP36.P$9
FPGA_95: IC4.95, JP3.32, JP36.P$32
FPGA_98: IC4.98, JP3.8, JP36.P$8
FPGA_TDI: IC1.83, IC4.100
HOLD: IC1.76, IC5.7
HSWAP: IC1.24, IC4.99
INIT_B: IC1.92, IC4.25
L2: JP3.2, JP36.P$2
L39: JP3.39, JP36.P$39
LED1: IC1.1, R1.1
LED2: IC1.2, R2.1
LED3: IC1.3, R3.1
LED4: IC1.4, R4.1
LED5: IC1.6, R5.1
LED6: IC1.7, R6.1
LED7: IC1.8, R7.1
LED8: IC1.9, R8.1
M0: IC1.36, IC4.43
M1: IC1.39, IC4.42
M2: IC1.42, IC4.39
MCLK: CLK.3, IC1.22, IC4.83
MOSI: IC1.90, IC4.27, IC5.5
unnamed: IC2.1, R22.1, R23.2
unnamed: IC2.2, R24.1, R25.2
unnamed: IC2.11, R18.1, R19.2
unnamed: C1.1, FB.1, MINI_B.1
unnamed: IC2.10, R20.1, R21.2
unnamed: IC2.13, L1.P$1
unnamed: IC2.8, L4.P$1
unnamed: IC2.5, L2.P$2
unnamed: IC2.4, L3.P$2
unnamed: C4.1, IC3.17
unnamed: LED1.C, R1.2
unnamed: LED2.C, R2.2
unnamed: LED3.C, R3.2
unnamed: LED4.C, R4.2
unnamed: LED5.C, R5.2
unnamed: LED6.C, R6.2
unnamed: LED7.C, R7.2
unnamed: LED8.C, R8.2
PROG_B: IC1.99, IC4.1
PWREN: IC1.43, IC3.12, R17.1
RD: IC1.50, IC3.13
RDWR_B: IC1.10, IC4.38
RST: IC1.14, IC3.19
RX: IC1.68, IC3.23
SW1: C25.1, IC1.74, R9.1, SW1.1
SW2: C26.1, IC1.72, R10.1, SW2.1
SW3: C27.1, IC1.71, R11.1, SW3.1
TCK: IC1.48, IC4.77, JP1.3
TDI: IC1.45, JP1.5
TDO: IC4.76, JP1.4
TMS: IC1.47, IC4.75, JP1.6
TX: IC1.67, IC3.22
USBDM: IC3.16, MINI_B.2
USBDP: IC3.15, MINI_B.3
VCC: C2.1, C3.1, C10.1, C11.2, FB.2, IC2.3, IC2.7, IC2.9, IC2.12, IC2.15, IC2.16
VCCAUX: C9.1, C12.1, C15.1, C19.1, IC1.5, IC4.21, IC4.46, IC4.74, IC4.96, JP1.1, L2.P$1, R24.2
VCCINT: C6.1, C17.1, C21.1, IC4.6, IC4.28, IC4.56, IC4.80, L1.P$2, R18.2
VCCO: C5.2, C7.1, C13.1, C14.1, C18.1, C22.1, C23.1, C24.+, CLK.4, IC1.38, IC1.51, IC1.88, IC1.98, IC3.4, IC3.20, IC4.8, IC4.20, IC4.31, IC4.45, IC4.55, IC4.73, IC4.82, IC4.97, IC5.8, JP3.1, JP4.1, JP36.P$1, L4.P$2, LED1.A, LED2.A, LED3.A, LED4.A, LED5.A, LED6.A, LED7.A, LED8.A, R9.2, R10.2, R11.2, R17.2, R20.2
VS0: IC1.30, IC4.49
VS1: IC1.33, IC4.48
VS2: IC1.34, IC4.47
WR: IC1.49, IC3.14
_D1: IC1.40, IC4.41
_D2: IC1.41, IC4.40
_D3: IC1.77, IC4.36
_D4: IC1.78, IC4.35
_D5: IC1.79, IC4.34
_D6: IC1.81, IC4.33
_D7: IC1.89, IC4.32
