cydrollinger/USB_FPGA/(commit log)

2019-04-05 first commit 4/5/19
    [7_7_9_usb_fpga.brd, 7_7_9_usb_fpga.sch, FPGA_pad.csv, _vhdl.psm, behavioral.psm, demo_pad.csv, demo_timesim.sdf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]
2019-04-06 changed the url for board 4/6/19
